madiabio/bass-synth/input.c

// Handles inputs
#include "function_gen.h"
#include "input.h"
#include "ES.h"
#include <TM4C129.h>
#include <stdint.h>
#include "config.h"
#include "display_utils.h"
volatile uint8_t note_on = 0;      // gate flag
volatile char key_pressed = -1;   // current key (-1 if none)
volatile int scan_ready = 0;
#define PK3 (1<<3)
#define PK0 (1<<0)
#define PK1 (1<<1)

#define PA1 (1<<1) // U0
#define PA0 (1<<0)	// U0
#define U3  (1<<3)
#define U0  (1<<0)

#define IRQ_NUMBER_GPIOE 4
#include "adc.h"
void init_UART0()
{
	SYSCTL->RCGCUART |= U0;   
	while((SYSCTL->PRUART & U0) == 0); 
	
	SYSCTL->RCGCGPIO |= (1 << 0);   
	while((SYSCTL->PRGPIO & (1 << 0)) == 0);

	GPIOA_AHB->AFSEL |= PA0 | PA1;  
	
	GPIOA_AHB->PCTL  |= (1<<0*4) | (1<<1*4);
	
	GPIOA_AHB->DEN  |= PA0 | PA1;

	UART0->CTL &= ~(1 << 0);        
	UART0->IBRD = 65;               
	UART0->FBRD = 7;               
	UART0->LCRH = (0x3 << 5);       // 8-bit, no parity, 1 stop
	UART0->CC   = 0;              // use sysclk
	UART0->CTL  = (1 << 9) | (1 << 8) | (1 << 0); // RXE, TXE, UEN
}

void init_timer0a() {
    SYSCTL->RCGCTIMER |= (1<<0); // enable timer 0 clock
		while((SYSCTL->PRTIMER & (1 << 0)) == 0) {}// Wait until ready

    TIMER0->CTL &= ~(1<<0); // disable during setup
    TIMER0->CFG = 0; // 32-bit timer
    
		TIMER0->TAMR = 0x2; // periodic mode
    TIMER0->TAILR = TIMER0A_RELOAD; // load value (defined in config.h)
    
		
	
		TIMER0->IMR |= (1<<0); // enable timeout interrupt
    
		// enable IRQ 19 to enable interrupts on NVIC for TIMER0 (see NVIC Register Descriptions in datasheet and TIMER0 Handler in regref/course notes)
		NVIC->IPR[19] = PRIORITY_TIMER0A; // set priority as defined in config header
		NVIC->ISER[0] |= (1<<19); // this is the same thing as NVIC_ENn in the data sheet
		TIMER0->CTL |= (1<<0) | (1 << 5); // enable Timer A output trigger for ADC and re-enable TAEN
}



// Timer0A Handler scans the keypad at periodic intervals, triggers the waveform state update, and also triggers the ADC to refresh
void TIMER0A_Handler(void) 
{
	TIMER0->ICR = 0x1;    // clear interrupt flag
	scan_keypad();        // scan
	handle_waveform_state(); // update waveform

	ADC0->PSSI |= (1 << 0);   // start conversion on sequencer 0
	while ((ADC0->RIS & (1 << 0)) == 0) { }  // wait for SS0 complete

	uint16_t ain7 = ADC0->SSFIFO0 & 0xFFF;
	uint16_t ain6 = ADC0->SSFIFO0 & 0xFFF;
	uint16_t ain8 = ADC0->SSFIFO0 & 0xFFF;

	ADC0->ISC = (1 << 0);  // clear SS0 interrupt

	updateADSR(ain7, ain6, ain8);
	envelope_updateParams();
}



void keypad_init(void)
{
	uint32_t GPIOK_and_GPIOE = ((1<<9) | (1<<4));
	SYSCTL->RCGCGPIO |= GPIOK_and_GPIOE;
	while ( (SYSCTL->PRGPIO & (GPIOK_and_GPIOE)) == 0 ) {}
	
		
	// Set as inputs
	GPIOK->DIR |= PKs;
	GPIOE_AHB->DIR &= ~PEs;
		
	// enable pull down resistor for switches
	GPIOK->DR2R |= PKs; // enable pins output to drive 2mA
	GPIOE_AHB->PDR |= PEs; // Enable pull down resistor
	
	// enable digital
	GPIOK->DEN  |= PKs;
	GPIOE_AHB->DEN |= PEs;

	// enable timer for scanning
}


void scan_keypad(void) {
    static const char keyMap[4][3] = {
        {'1','2','3'},
        {'4','5','6'},
        {'7','8','9'},
        {'*','0','#'}
    };
    for (int col = 0; col < 3; col++) {
        GPIOK->DATA &= ~0x07;          // all low
        GPIOK->DATA |= (1 << col);     // one high
        ES_usDelay(50);
        uint32_t rows = GPIOE_AHB->DATA & 0x0F;

        for (int row = 0; row < 4; row++) {
            if ((rows >> row) & 1) {
                key_pressed = keyMap[row][col];
								// ES_Uprintf(0, "Key Pressed: %c\n", key_pressed);
                note_on = 1;
							
								// map key to note index 
                uint8_t note_index;
                switch (key_pressed) {
                    case '1': note_index = 0; break;   // C
                    case '2': note_index = 1; break;   // C#
                    case '3': note_index = 2; break;   // D
                    case '4': note_index = 3; break;   // D#
                    case '5': note_index = 4; break;   // E
                    case '6': note_index = 5; break;   // F
                    case '7': note_index = 6; break;   // F#
                    case '8': note_index = 7; break;   // G
                    case '9': note_index = 8; break;   // G#
                    case '*': note_index = 9; break;   // A
                    case '0': note_index = 10; break;  // A#
                    case '#': note_index = 11; break;  // B
                    default: return;
                }

                handle_note_input(note_index, true);

                // ES_Uprintf(0, "Note: %s\n", chromatic[note_index].name);
                return;  // leave after first press
            }
        }
    }
    // if no key pressed
    note_on = 0;
    key_pressed = -1;
}
