madiabio/bass-synth/(commit log)

2025-09-29 Wrote I2C drivers (untested)
2025-10-01 SCL I2C Works, but the DAC is not acking still.
2025-10-01 I2C doesn't work. Beginning I2S
    [config.h, function_gen.c, main.c]
2025-10-02 I2S, SPI drivers written. SPI definitely works for SPI2, but I2S unconfirmed (unlikely to be working) and SPI for 12 bit DAC is also unconfirmed.
2025-10-02 Gets past initLCD, but stuck on setRotation
    [SSI.c]
2025-10-02 SPI for the display DEFINITELY works 10000000% from thsi commit. DO NOT touch it anymore. If any problems, it is WITHOUT A DOUBT your wiring.
    [SSI.c, main.c]
2025-10-02 It works when I have the I2S interrupts running in the background. Just a check
2025-10-02 Drawing is being triggered by the I2S interrupt
2025-10-02 Started drawing screen but its broken
    [SSI.c, config.h, function_gen.c, function_gen.h, main.c]
2025-10-03 SSI1 Definitely configured correctly
    [SSI.c, SSI.h, main.c]
2025-10-03 FixSSI1, TX and RX were flipped!!!
    [SSI.c, SSI.h]
2025-10-03 Fixed SSI3, TX and RX were flipped. Confimred owrking now.
    [SSI.c, SSI.h, main.c]
2025-10-03 Started writing DMA
2025-10-04 Wrote scope ring buffer and completed DMA skeleton - untested
2025-10-04 Fixed ordering of test_i2s_circuit calls
    [main.c]
2025-10-04 DMA working. Also made a button work
2025-10-04 Can now cycle through waveforms with a physical button
2025-10-05 UART0 works for printing to terminal
2025-10-05 Keypad is fixed to work with higher system clock frequency
    [input.c, input.h, main.c]
2025-10-05 A note plays when keypad is pressed, but currently there's a background whirr
2025-10-05 Keypad scanning now handled by timer with interrupts
2025-10-05 Keypad scanning is now interrupt driven
2025-10-06 Button kind of works with keypad now on the interrupt, but it still has unpredictable transitions sometimes.
2025-10-06 Button works with keypad and sound output
2025-10-06 Took handle_waveform_state out of main function, its now onyl handled by the interrupt.
2025-10-06 All but one waveform responds to pitch now
2025-10-06 Square wave makes sound now but doesnt respond to pitch
2025-10-06 Increased rate of SPI display
2025-10-07 ADC works, all waves respond to pitch changes
2025-10-07 Waveform sample displays on screen
2025-10-07 ADC values stream to display
2025-10-08 48kHz sample rate, everything functioning harmoniously
2025-10-08 Removed unnecessary uart print statements
